adakarda/dengerobot/elektronik/cdtp_robot.pdf

1 | 2 | 3 | 4 | 5 | 6 | 7 | 8
1 | 2 | 3 | 4 | 5 | 6 | 7 | 8

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
Size: A3 | Rev: v1.3 | F Date: 2026-10-29
KiCad E.D.A. 10.0.6 | Id: 1/1

## Title: CDTP denge robotu - robot elektronigi

### File: cdtp_robot.kicad_sch

### Sheet: /

YTU EEF CDTP

### Uretici: tools/kicad_sema.py (elle duzenlemeyin; betigi degistirip yeniden uretin)

B- 1 | B1 2 | B2 3 | B+ 4 | P- | 5 U2 HX-3S-01

1
2
3

J6 GENISLEME: IR goz sol (bos) 1

2

# J9 GENISLEME: sarj girisi (bos) 1

2
3
4

J5

Enkoder sag NC1 1 | NC2 | 2

S1 NP2-BE102 NC

BT3

18650 hucre 3

1
2
3
4

J4

Enkoder sol 1
2

J1

5 V klemens | VCC 1 | GND 2

SCL 3
SDA 4
XDA 5
XCL 6
AD0 7
INT 8

A1 GY-521 C5

1000uF 25V +

1 | -
2 | J11
XT60 disi (pil) | R1

100k

BT1

18650 hucre 1

1
2
3
4
5
X2 WAGO-GND (yildiz) | 1

2
3
4

J13 GENISLEME: I2C (ekran, 2. sensor)

3V3 1
EN 2 | GPIO36_VP 3 | GPIO39_VN 4 | GPIO34 5 | GPIO35 6 | GPIO32 7 | GPIO33 8 | GPIO25 9 | GPIO26 10 | GPIO27 11 | GPIO14 12 | GPIO12 13 | GND 14 | GPIO13 15

SD2 16
SD3 17 | CMD 18
5V 19 | GND | 20 GPIO23 | 21 GPIO22 | 22
TX_GPIO1 | 23 RX_GPIO3 | 24 GPIO21 | 25 GND | 26 GPIO19 | 27 GPIO18 | 28 GPIO5 | 29 GPIO17 | 30 GPIO16 | 31 GPIO4 | 32 GPIO0 | 33 GPIO2 | 34 GPIO15 | 35
SD1 | 36
SD0 | 37 CLK | 38 U1

ESP32-WROOM-32D DevKitC

1
2
3

J7 GENISLEME: IR goz sag (bos) R5

10k

F1

5 A bicak BT2

# 18650 hucre 2 +

1 | -
2 | J12
XT60 erkek (robot) | 1
| 2
| 3
| 4
| 5

X1 WAGO-12V

JP1 USB'de cikar C1

100uF 16V

IN+ 1

IN- 2 | OUT+ | 3 OUT- | 4 U3
LM2596 5,0 V | 1

2

J10 Motor hatti klemens

C4

# 100nF R4

27k R7

33k 1
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
J3 BTS sol | R3

100k R2

27k C2

# 100nF R6

100k C3

100nF 1
2
3
4
5
J8 BTS sag | M1 1 | GND | 2 C1 | 3 C2 | 4
VCC | 5 M2 6 | M2
JGB37-520 sag M1 1 | GND | 2 C1 | 3 C2 | 4
VCC | 5 M2 6 | M1

# JGB37-520 sol RPWM 1

LPWM 2 | R_EN 3
L_EN 4 | R_IS 5

L_IS 6

VCC 7 | GND 8 | B+ | 9 B- | 10 M+ | 11 M- | 12

# A2 BTS7960 sol RPWM 1

LPWM 2 | R_EN 3
L_EN 4 | R_IS 5

L_IS 6

VCC 7 | GND 8 | B+ | 9 B- | 10 M+ | 11 M- | 12

# A3 BTS7960 sag

I2C_SCL

B1 | +12V
B1 | +3V3

I2C_SDA

B2 | B2

IR_L PACK+
IR_R

PACK-

CHG+

VBAT_ADC
ENC_L_A ENC_L_B
ENC_R_A ENC_R_B | MOT_L- +12V B-

ENC_R_B +12V B2 PACK+

MOT_L+

PACK+

+3V3 PACK-

GND

R_LPWM

BAT+

R_RPWM
MOTOR_EN
GND | +12V_MOT | GND +12V_MOT

IMU_INT +3V3 BAT+

I2C_SDA +12V +12V +12V +12V +12V | GND
L_LPWM +12V_MOT | L_RPWM

# R_LPWM +3V3 GND

R_RPWM

GND | MOTOR_EN MOTOR_EN

GND

L_LPWM +3V3

L_RPWM +5V_ESP

GND

IR_L +5V

VBAT_ADC

B1 | GND

GND
GND
GND
GND

GND

GND +5V
I2C_SCL ENC_R_A GND
GND +5V | +12V_MOT GND +12V +3V3 | MOTOR_SENSE | GND

ENC_L_A GND

I2C_SCL
I2C_SDA
IMU_INT +3V3 +12V

VBAT_ADC

CHG+ | VCHG_ADC
VCHG_ADC | GND

GND

VBAT_ADC | GND

GND +5V_ESP

GND

GND

GND

MOTOR_EN +3V3 GND

I2C_SDA | MOTOR_SENSE GND MOTOR_EN

VCHG_ADC +12V_MOT MOTOR_SENSE

IR_R | MOT_L+ MOT_L-

GND

# ENC_R_A ENC_R_B +3V3 GND

ENC_L_A ENC_L_B +3V3 MOT_R-

MOT_R+

+5V

VCHG_ADC

I2C_SCL GND

IMU_INT GND MOTOR_SENSE | +3V3 GND

L_RPWM
L_LPWM
MOTOR_EN +3V3 | +3V3 GND
ENC_L_B | +3V3 GND

B-

+12V_MOT GND MOT_R+

MOT_R-

R_RPWM
R_LPWM
MOTOR_EN MOTOR_EN Sarj eklentisi (sonra): pogo + -> SR5100 anot, katot -> BAT+ (sigortadan once), pogo + ayrica J9-2. R3/R4 GPIO34'u 0 V'ta tutar.

Guc: pil -> BMS -> XT60 -> F1 5 A -> WAGO-12V. Acil stop (NC) yalniz motor hattini keser; ESP32 acik kalir.

ANA KART: ESP32 VE BESLEME | MODULLER VE MOTORLAR

KAPSAM: yalniz dengede kalan, pilli robot. GENISLEME konnektorleri (J6, J7, J9, J13) bos birakildi; sarj, IR goz, ekran sonradan buraya takilir.

JP1: kod yuklerken (USB takiliyken) cikarin; LM2596 ile USB 5 V'u cakismasin.

# ANA KART: KONNEKTOR, OLCUM

CDTP denge robotu - robot elektronigi (tek sayfa). Ayni adli etiketler ayni hattir.

Bolucu: R1/R2 ve R3/R4 100k/27k (12,6 V -> 2,68 V); R6/R7 100k/33k (12,6 V -> 3,13 V).

PIL VE BMS | 12 V DAGITIM

BTS7960 VCC = 3,3 V (ESP32 seviyesi). R_EN ve L_EN iki kartta GPIO4'e; R5 10k ile acilista motorlar kapali.

Kablo numaralari (W1-W44) ve pin sirasi: docs/robot.html bolum 04, 06, 07.

MPU6050 AD0 -> GND (adres 0x68). GPIO36/39 yalniz giris (IR, PCNT 12,8 us suzgec).
