adakarda/dengerobot/cad/dxf/onizleme.png

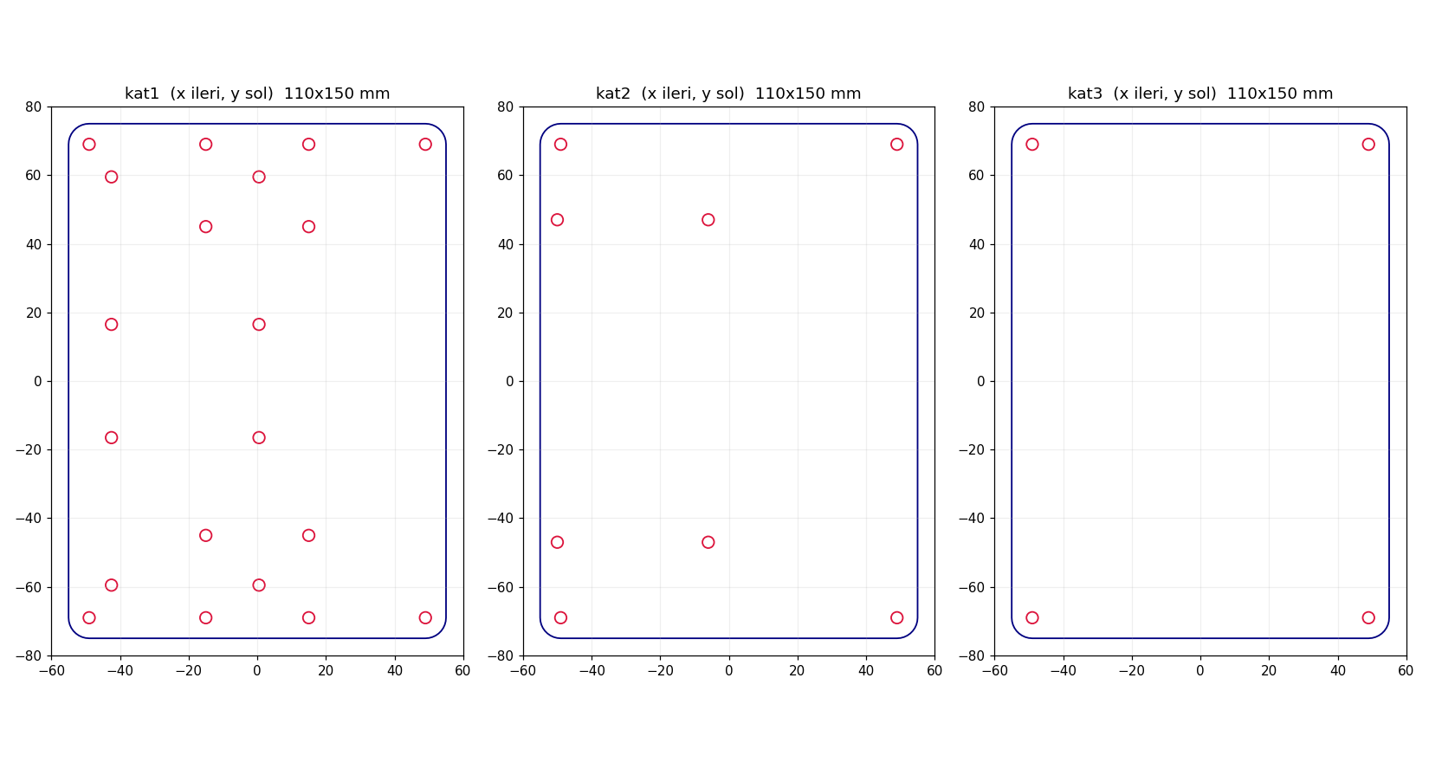
cad/dxf/onizleme.png
