adakarda/dengerobot/cad/dxf/yerlesim.png

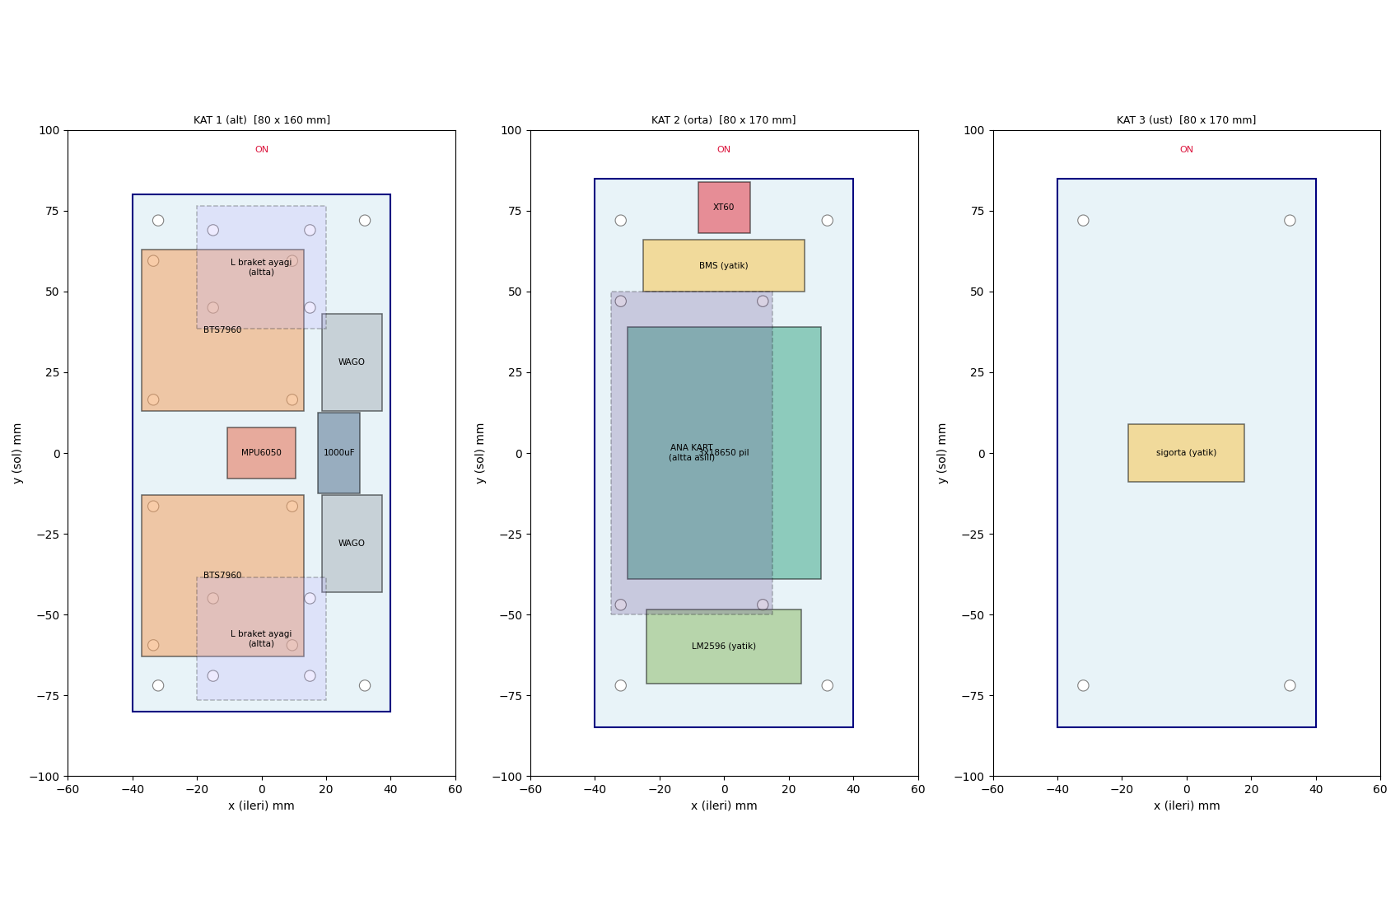
cad/dxf/yerlesim.png
