adakarda/dengerobot/docs/img/c1_ileri.png

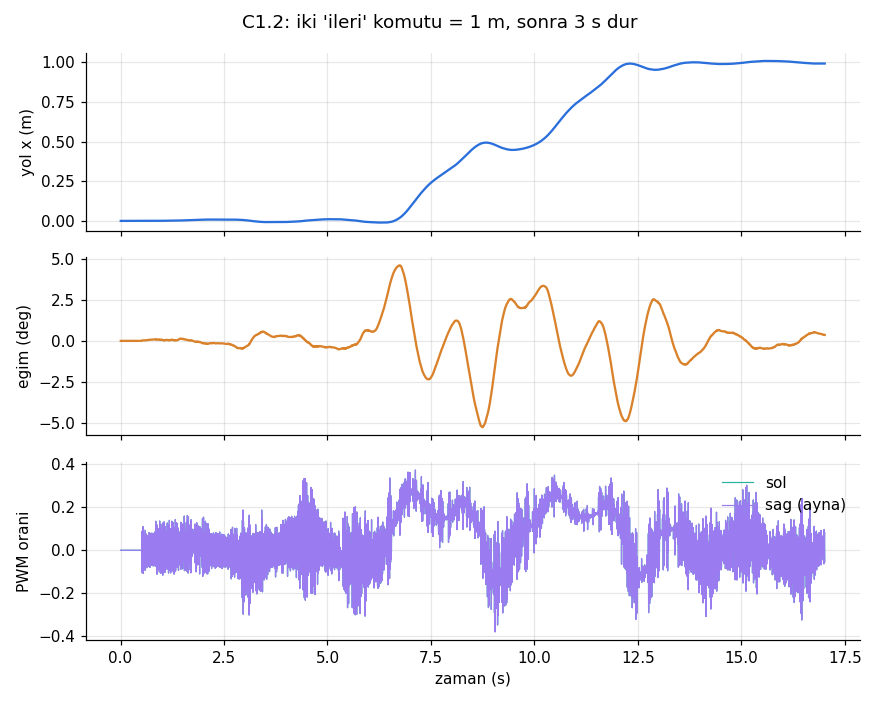
docs/img/c1_ileri.png
