adakarda/dengerobot/docs/img/c1_toparlanma.png

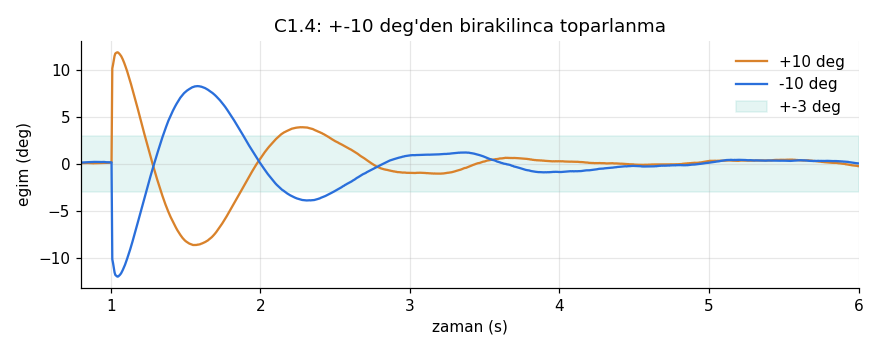
docs/img/c1_toparlanma.png
