adakarda/dengerobot/docs/img/c2_eldiven.png

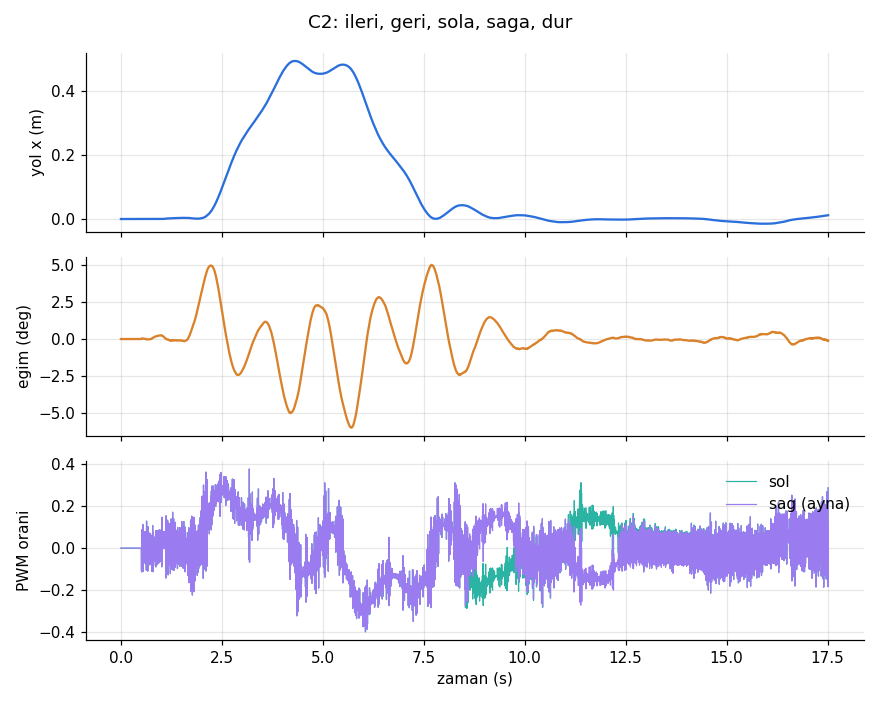
docs/img/c2_eldiven.png
