adakarda/dengerobot/docs/img/cad_parcalar.png

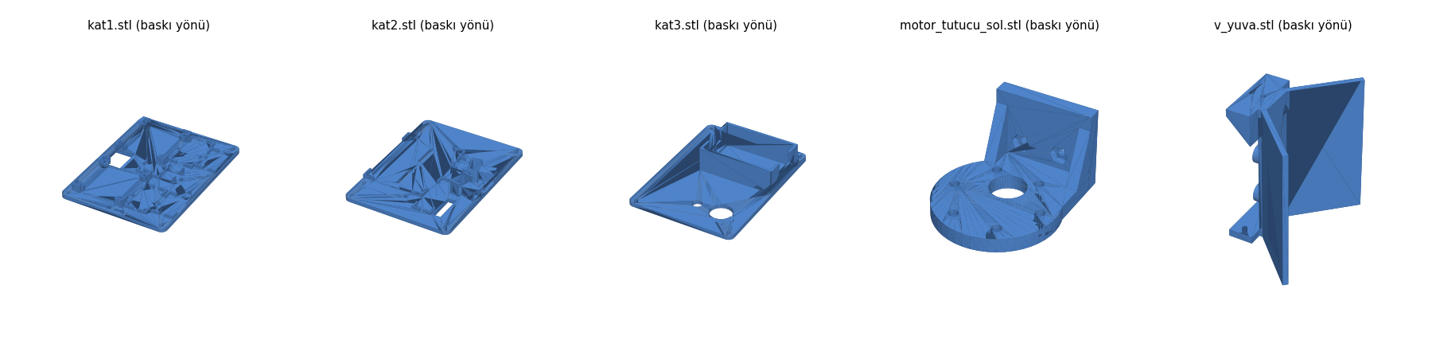
docs/img/cad_parcalar.png
