adakarda/dengerobot/docs/img/ikiz_karsilastirma.png

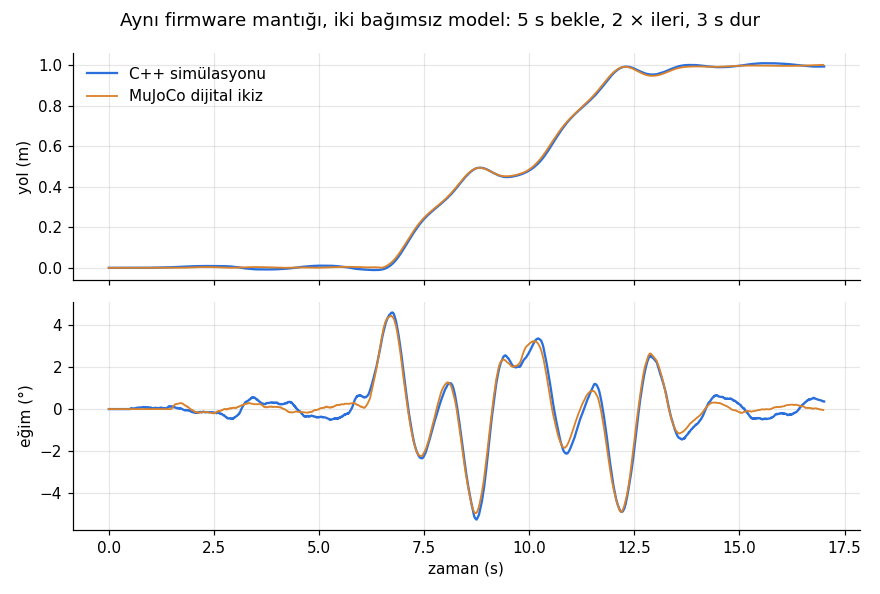
docs/img/ikiz_karsilastirma.png
