adakarda/dengerobot/docs/img/ikiz_yanasma.png

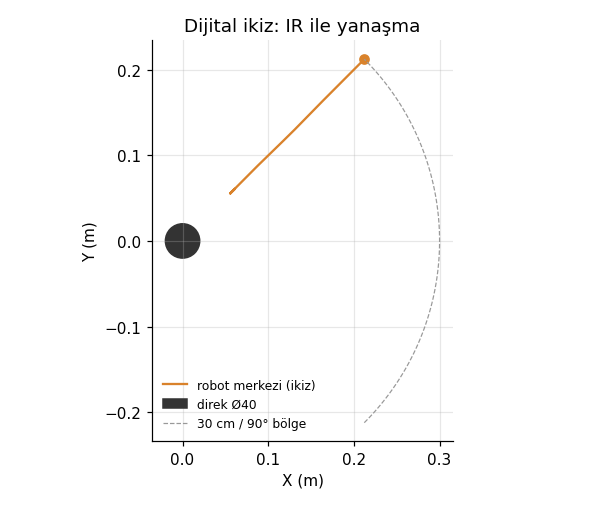
docs/img/ikiz_yanasma.png
