adakarda/dengerobot/docs/img/yanasma_yolu.png

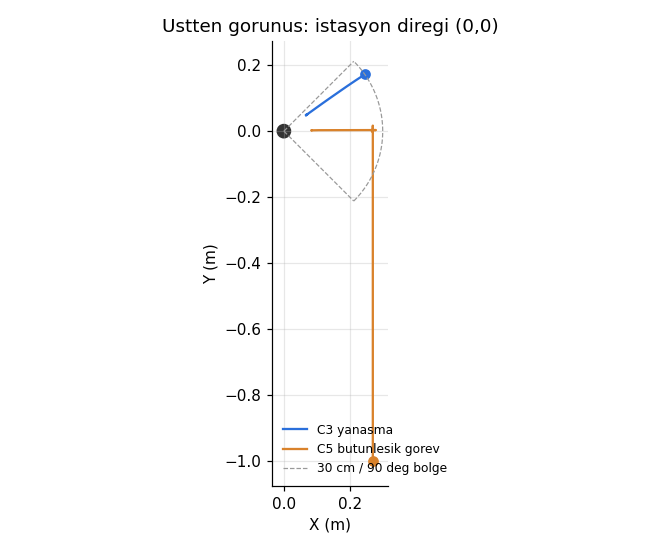
docs/img/yanasma_yolu.png
