adakarda/dengerobot/elektronik/pcb_v2/onizleme_alt.png

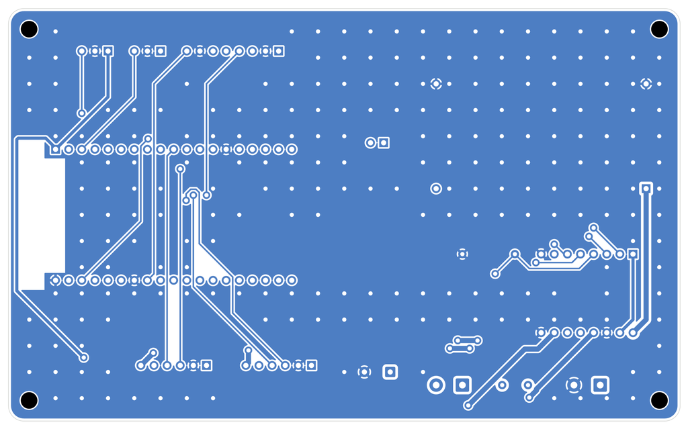
elektronik/pcb_v2/onizleme_alt.png
