adakarda/dengerobot/elektronik/pcb_v2/onizleme_ust.png

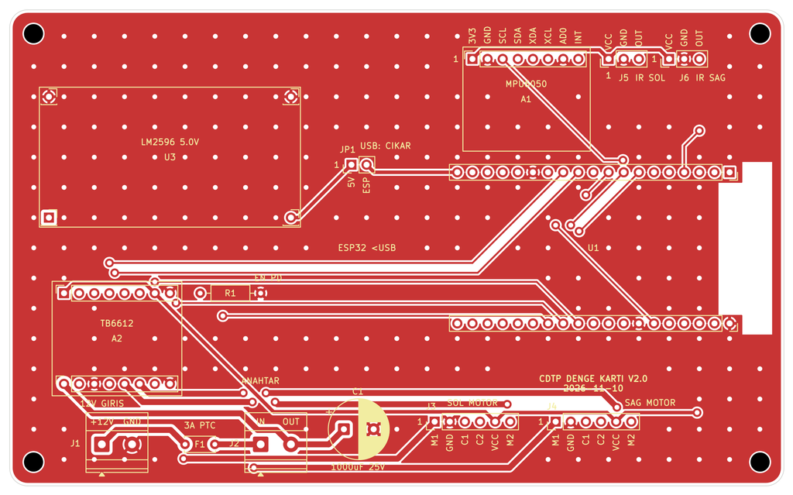
elektronik/pcb_v2/onizleme_ust.png
