adakarda/dengerobot/cad/dxf/pleksi_hepsi.dxf

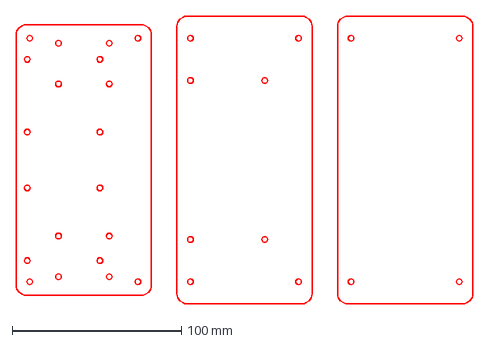
[picture p26: CAD file, 2026-11-11]
cad/dxf/pleksi_hepsi.dxf
270.0 x 170.0 mm
