adakarda/dengerobot/cad/stl/motor_tutucu_sag.stl

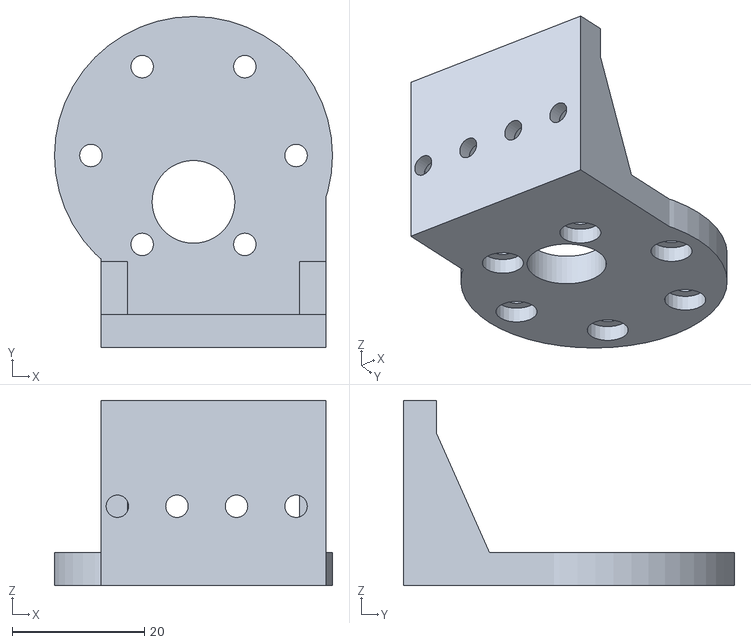
[picture p27: CAD file, 2026-11-11]
cad/stl/motor_tutucu_sag.stl
42.0 x 50.0 x 28.0
