adakarda/dengerobot/cad/stl/motor_braket_37mm.stl

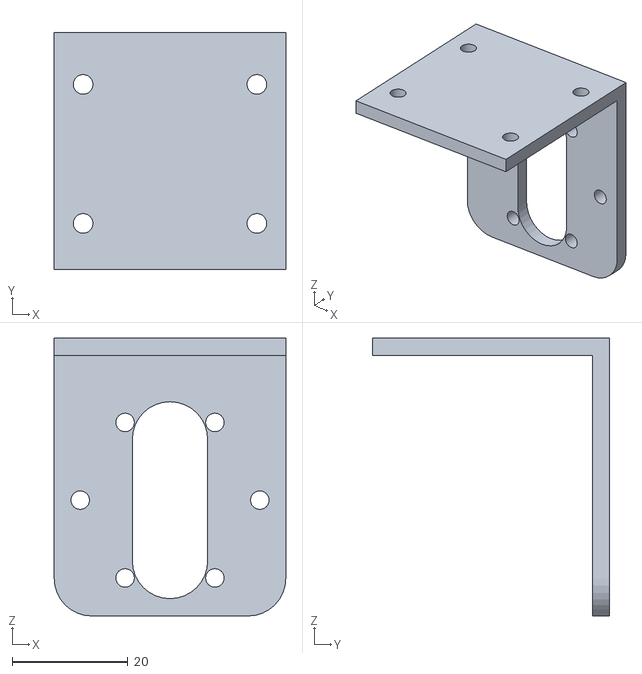
[picture p28: CAD file, 2026-11-11]
cad/stl/motor_braket_37mm.stl
40.0 x 41.0 x 48.0
