adakarda/dengerobot/cad/stl/kat1.stl

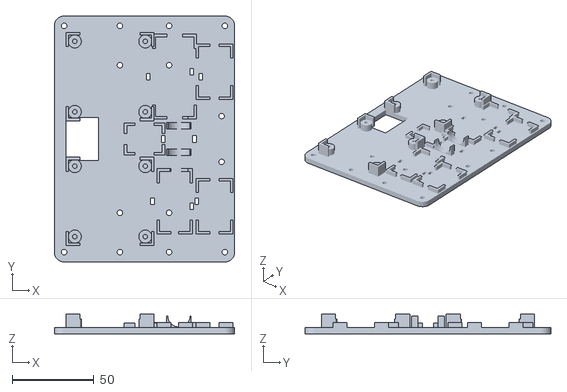
[picture p29: CAD file, 2026-11-11]
cad/stl/kat1.stl
110.0 x 150.0 x 12.0
