adakarda/dengerobot/cad/stl/teker_kapak_B.stl

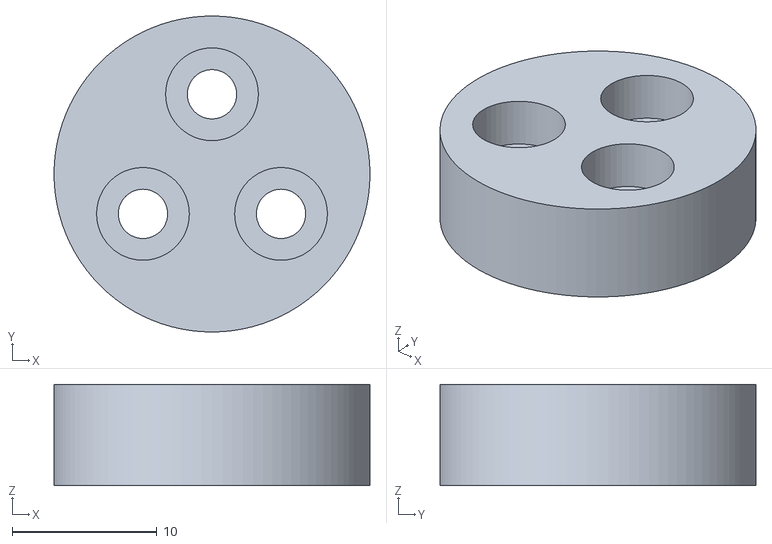
[picture p30: CAD file, 2026-11-05]
cad/stl/teker_kapak_B.stl
21.8 x 21.8 x 7.00
