adakarda/dengerobot/cad/stl/teker_olcu_testi.stl

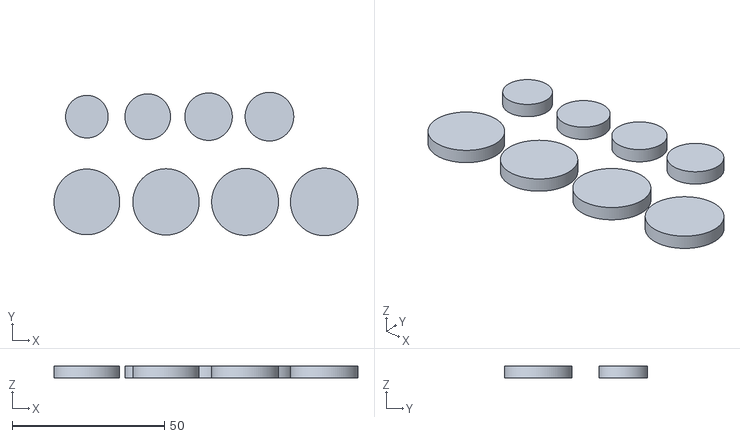
[picture p31: CAD file, 2026-11-05]
cad/stl/teker_olcu_testi.stl
99.9 x 47.1 x 4.00
