adakarda/dengerobot/cad/stl/teker_gobek_A.stl

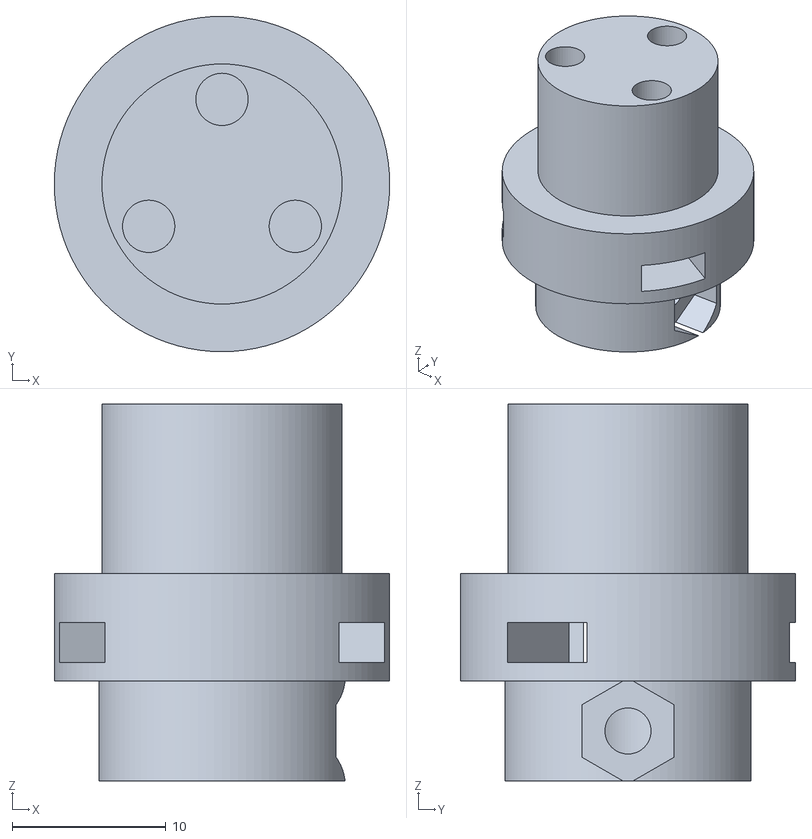
[picture p32: CAD file, 2026-11-05]
cad/stl/teker_gobek_A.stl
21.8 x 21.8 x 24.5
