adakarda/dengerobot/cad/stl/v_yuva.stl

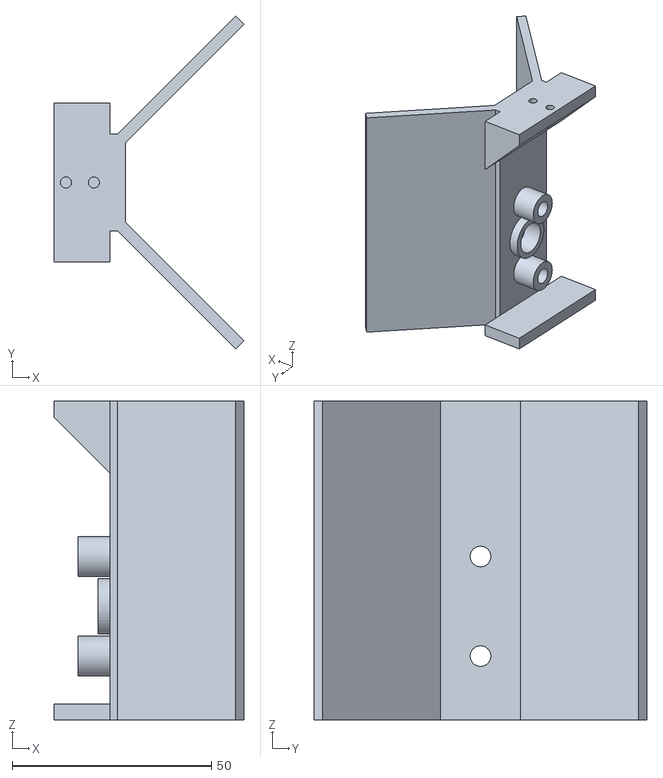
[picture p33: CAD file, 2026-11-05]
cad/stl/v_yuva.stl
47.7 x 83.6 x 80.0
