adakarda/dengerobot/cad/stl/kat2.stl

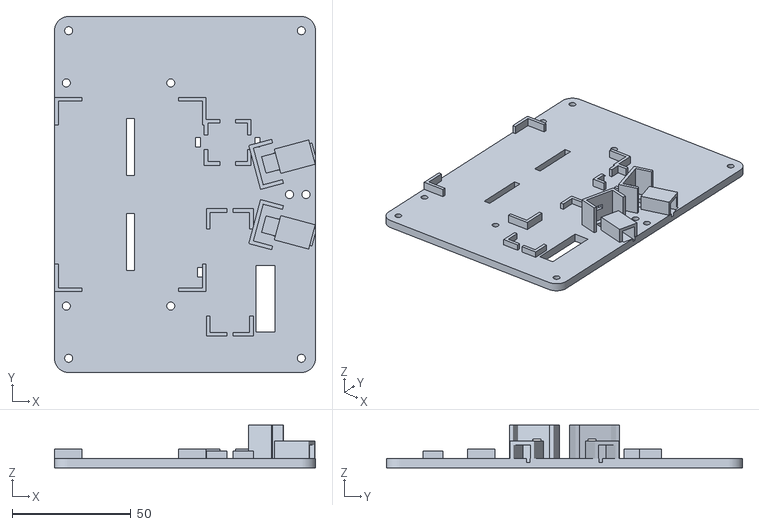
[picture p34: CAD file, 2026-11-05]
cad/stl/kat2.stl
110.0 x 150.0 x 18.0
