adakarda/dengerobot/cad/stl/kat3.stl

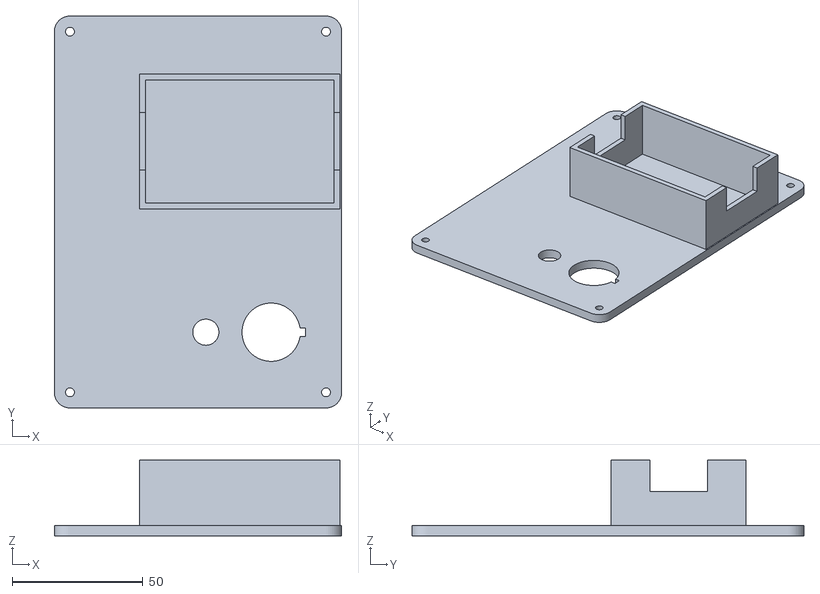
[picture p35: CAD file, 2026-10-29]
cad/stl/kat3.stl
110.0 x 150.0 x 29.0
