adakarda/dengerobot/(list of files, cad)

Other CAD files:
cad/stl/motor_tutucu_sol.stl
cad/dxf/kat1.dxf
cad/dxf/kat2.dxf
cad/dxf/kat3.dxf
