adakarda/dengerobot/docs/img/cad_montaj.png

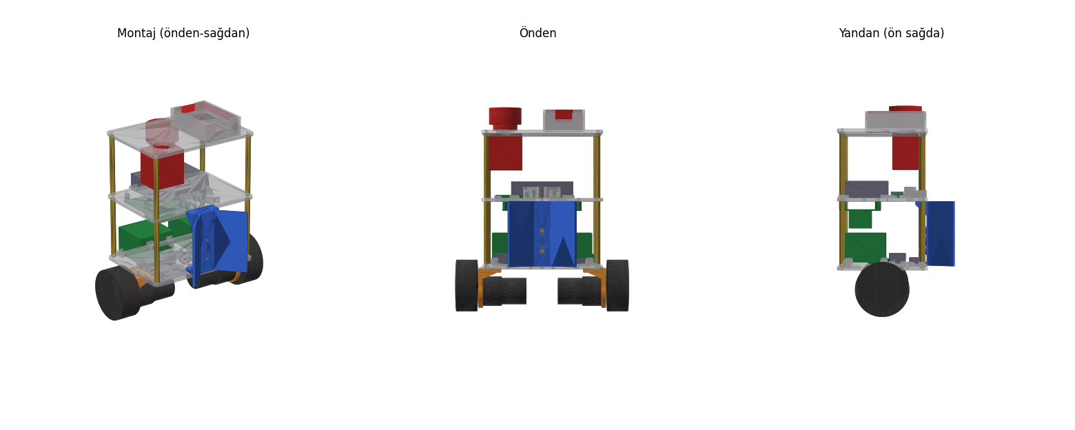
docs/img/cad_montaj.png
