adakarda/dengerobot/sim/results/filtre_izgara.tsv

q_theta | r_acc | q_bias | rms_ort_deg | bias_ort_dps
1e-008 | 0.0004 | 1e-013 | 0.2566 | 0.0015
1e-008 | 0.0004 | 1e-011 | 0.2567 | 0.0015
1e-008 | 0.0004 | 1e-009 | 0.2681 | 0.0025
1e-008 | 0.0004 | 1e-007 | 0.4712 | 0.0191
1e-008 | 0.0016 | 1e-013 | 0.2533 | 0.0014
1e-008 | 0.0016 | 1e-011 | 0.2533 | 0.0014
1e-008 | 0.0016 | 1e-009 | 0.2562 | 0.0015
1e-008 | 0.0016 | 1e-007 | 0.3762 | 0.0119
1e-008 | 0.0064 | 1e-013 | 0.2515 | 0.0014
1e-008 | 0.0064 | 1e-011 | 0.2515 | 0.0014
1e-008 | 0.0064 | 1e-009 | 0.2522 | 0.0014
1e-008 | 0.0064 | 1e-007 | 0.3065 | 0.0102
1e-008 | 0.025 | 1e-013 | 0.2540 | 0.0014
1e-008 | 0.025 | 1e-011 | 0.2540 | 0.0014
1e-008 | 0.025 | 1e-009 | 0.2542 | 0.0014
1e-008 | 0.025 | 1e-007 | 0.2722 | 0.0034
1e-008 | 0.1 | 1e-013 | 0.2757 | 0.0017
1e-008 | 0.1 | 1e-011 | 0.2757 | 0.0017
1e-008 | 0.1 | 1e-009 | 0.2758 | 0.0017
1e-008 | 0.1 | 1e-007 | 0.2799 | 0.0016
1e-008 | 0.4 | 1e-013 | 0.3532 | 0.0034
1e-008 | 0.4 | 1e-011 | 0.3532 | 0.0034
1e-008 | 0.4 | 1e-009 | 0.3532 | 0.0034
1e-008 | 0.4 | 1e-007 | 0.3528 | 0.0023
1e-008 | 1.6 | 1e-013 | 0.5671 | 0.0118
1e-008 | 1.6 | 1e-011 | 0.5671 | 0.0118
1e-008 | 1.6 | 1e-009 | 0.5670 | 0.0118
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
