adakarda/dengerobot/sim/results/gozleyici_izgara.tsv

sa | salpha | rx | rth_deg | v_rms | th_rms_deg | om_rms_dps
0.5 | 5 | 0.0005 | 0.1 | 0.00000 | 0.0060 | 0.2511
0.5 | 5 | 0.0005 | 0.1 | 1.00000 | 0.0058 | 0.2422
0.5 | 5 | 0.0005 | 0.1 | 4.00000 | 0.0059 | 0.2416
0.5 | 5 | 0.0005 | 0.1 | 16.00000 | 0.0063 | 0.2415
0.5 | 5 | 0.0005 | 0.3 | 0.00000 | 0.0060 | 0.2346
0.5 | 5 | 0.0005 | 0.3 | 1.00000 | 0.0058 | 0.2443
0.5 | 5 | 0.0005 | 0.3 | 4.00000 | 0.0057 | 0.2428
0.5 | 5 | 0.0005 | 0.3 | 16.00000 | 0.0058 | 0.2427
0.5 | 5 | 0.002 | 0.1 | 0.00000 | 0.0082 | 0.2458
0.5 | 5 | 0.002 | 0.1 | 1.00000 | 0.0074 | 0.2422
0.5 | 5 | 0.002 | 0.1 | 4.00000 | 0.0074 | 0.2416
0.5 | 5 | 0.002 | 0.1 | 16.00000 | 0.0080 | 0.2414
0.5 | 5 | 0.002 | 0.3 | 0.00000 | 0.0073 | 0.2330
0.5 | 5 | 0.002 | 0.3 | 1.00000 | 0.0073 | 0.2443
0.5 | 5 | 0.002 | 0.3 | 4.00000 | 0.0065 | 0.2428
0.5 | 5 | 0.002 | 0.3 | 16.00000 | 0.0062 | 0.2426
0.5 | 5 | 0.008 | 0.1 | 0.00000 | 0.0145 | 0.2325
0.5 | 5 | 0.008 | 0.1 | 1.00000 | 0.0108 | 0.2421
0.5 | 5 | 0.008 | 0.1 | 4.00000 | 0.0112 | 0.2416
0.5 | 5 | 0.008 | 0.1 | 16.00000 | 0.0131 | 0.2413
0.5 | 5 | 0.008 | 0.3 | 0.00000 | 0.0104 | 0.2192
0.5 | 5 | 0.008 | 0.3 | 1.00000 | 0.0106 | 0.2442
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
