adakarda/dengerobot/sim/results/gozleyici_karsilastirma.tsv

kestirim | v_ort_mms | v_kotu_mms | th_ort_deg | th_kotu_deg | om_ort_dps | om_kotu_dps
dogrudan (enkoder farki) | 4.139 | 4.266 | 0.2383 | 0.2573 | 2.4982 | 2.6957
gozleyici, gains.h | 4.725 | 5.171 | 0.2385 | 0.2576 | 2.4982 | 2.6957
gozleyici, izgara en iyisi | 4.725 | 5.171 | 0.2385 | 0.2576 | 2.4982 | 2.6957
