adakarda/dengerobot/sim_step/results/17HS3401S_c1_back.csv

t_s | x_m | v_mps | theta_deg | psi_deg | T_L_Ncm | T_R_Ncm | T_pullout_Ncm | wheel_rate_rad_s | x_deadreckoned_m | slips_total | mode
0.0050 | 0.00000 | 0.0000 | 0.000 | 0.000 | 0.00 | 0.00 | 0.00 | 0.000 | -0.00001 | 0 | 0
0.0100 | 0.00000 | 0.0000 | 0.000 | 0.000 | 0.00 | 0.00 | 0.00 | 0.000 | -0.00001 | 0 | 0
0.0150 | 0.00000 | 0.0000 | 0.000 | 0.000 | 0.00 | 0.00 | 0.00 | 0.000 | -0.00001 | 0 | 0
0.0200 | 0.00000 | 0.0000 | 0.000 | 0.000 | 0.00 | 0.00 | 0.00 | 0.000 | -0.00001 | 0 | 0
0.0250 | 0.00000 | 0.0000 | 0.000 | 0.000 | 0.00 | 0.00 | 0.00 | 0.000 | -0.00001 | 0 | 0
0.0300 | 0.00000 | 0.0000 | 0.000 | 0.000 | 0.00 | 0.00 | 0.00 | 0.000 | -0.00001 | 0 | 0
0.0350 | 0.00000 | 0.0000 | 0.000 | 0.000 | 0.00 | 0.00 | 0.00 | 0.000 | -0.00001 | 0 | 0
0.0400 | 0.00000 | 0.0000 | 0.000 | 0.000 | 0.00 | 0.00 | 0.00 | 0.000 | -0.00001 | 0 | 0
0.0450 | 0.00000 | 0.0000 | 0.000 | 0.000 | 0.00 | 0.00 | 0.00 | 0.000 | -0.00001 | 0 | 0
0.0500 | 0.00000 | 0.0000 | 0.000 | 0.000 | 0.00 | 0.00 | 0.00 | 0.000 | -0.00001 | 0 | 0
0.0550 | 0.00000 | 0.0000 | 0.000 | 0.000 | 0.00 | 0.00 | 0.00 | 0.000 | -0.00001 | 0 | 0
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
