adakarda/dengerobot/sim_step/results/recovery_limit.png

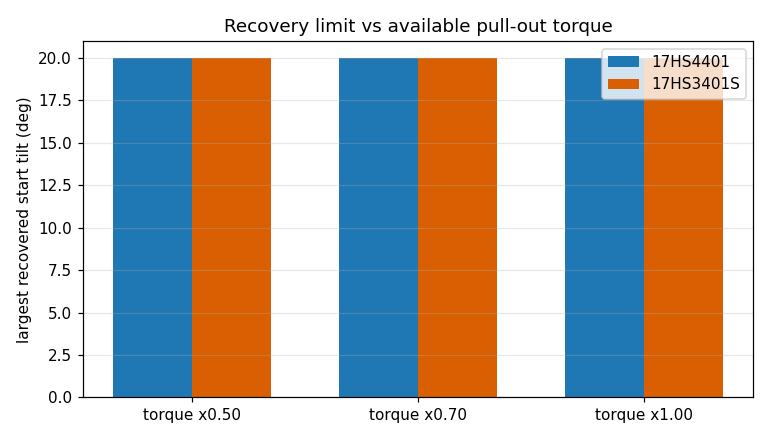
sim_step/results/recovery_limit.png
