adakarda/dengerobot/sim_step/results/recovery_plus10.png

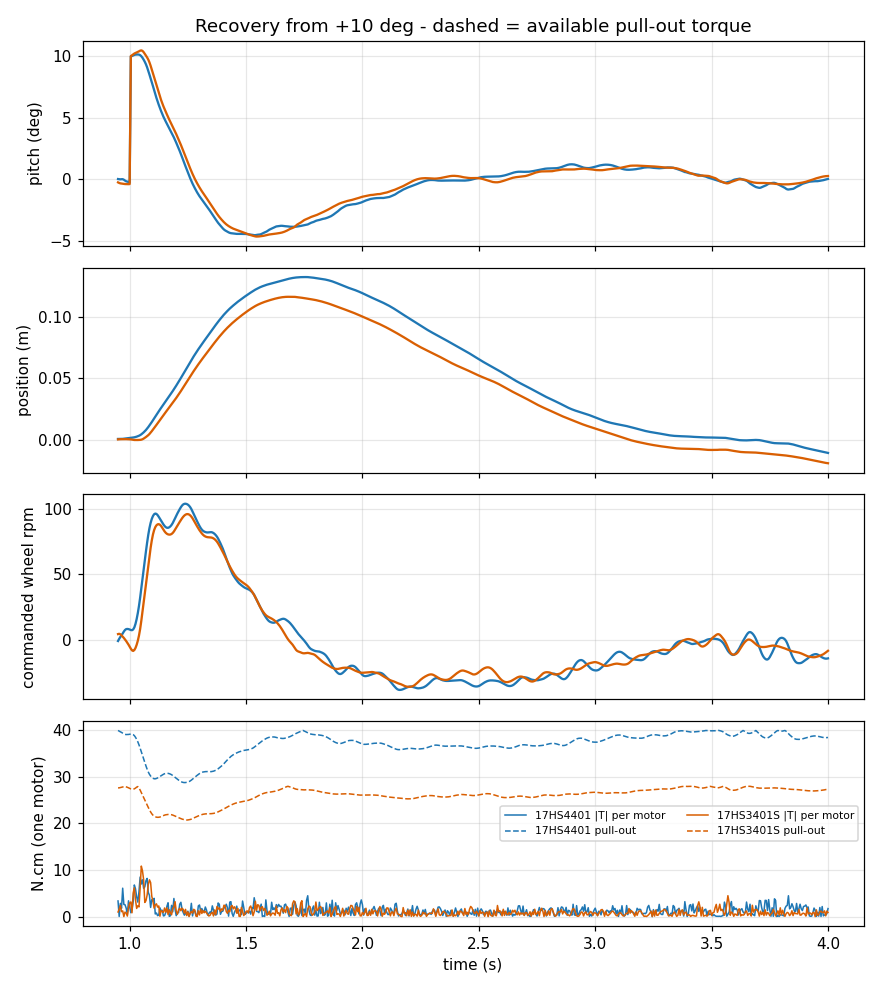
sim_step/results/recovery_plus10.png
