adakarda/dengerobot/sim_step/results/run_1m_forward.png

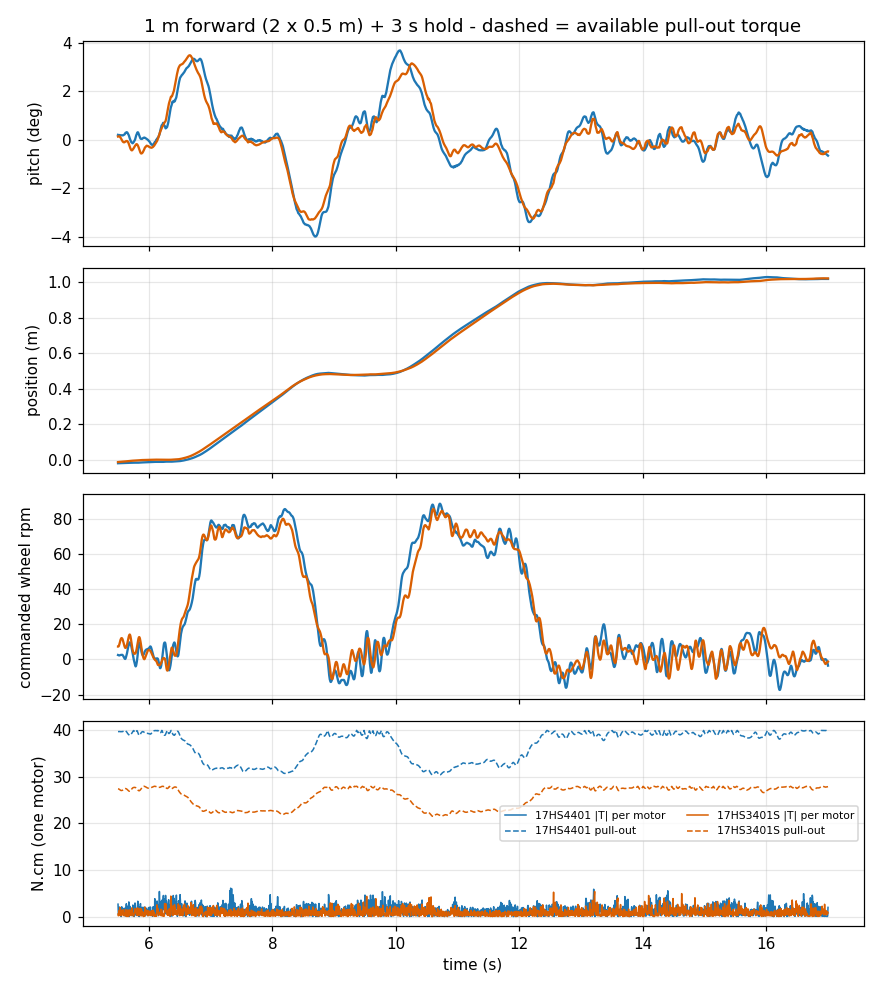
sim_step/results/run_1m_forward.png
