adakarda/dengerobot/elektronik/pcb_v2/cdtp_ana_kart_v2.kicad_pcb

## KiCad design elektronik/pcb_v2/cdtp_ana_kart_v2.kicad_pcb (2026-11-11)

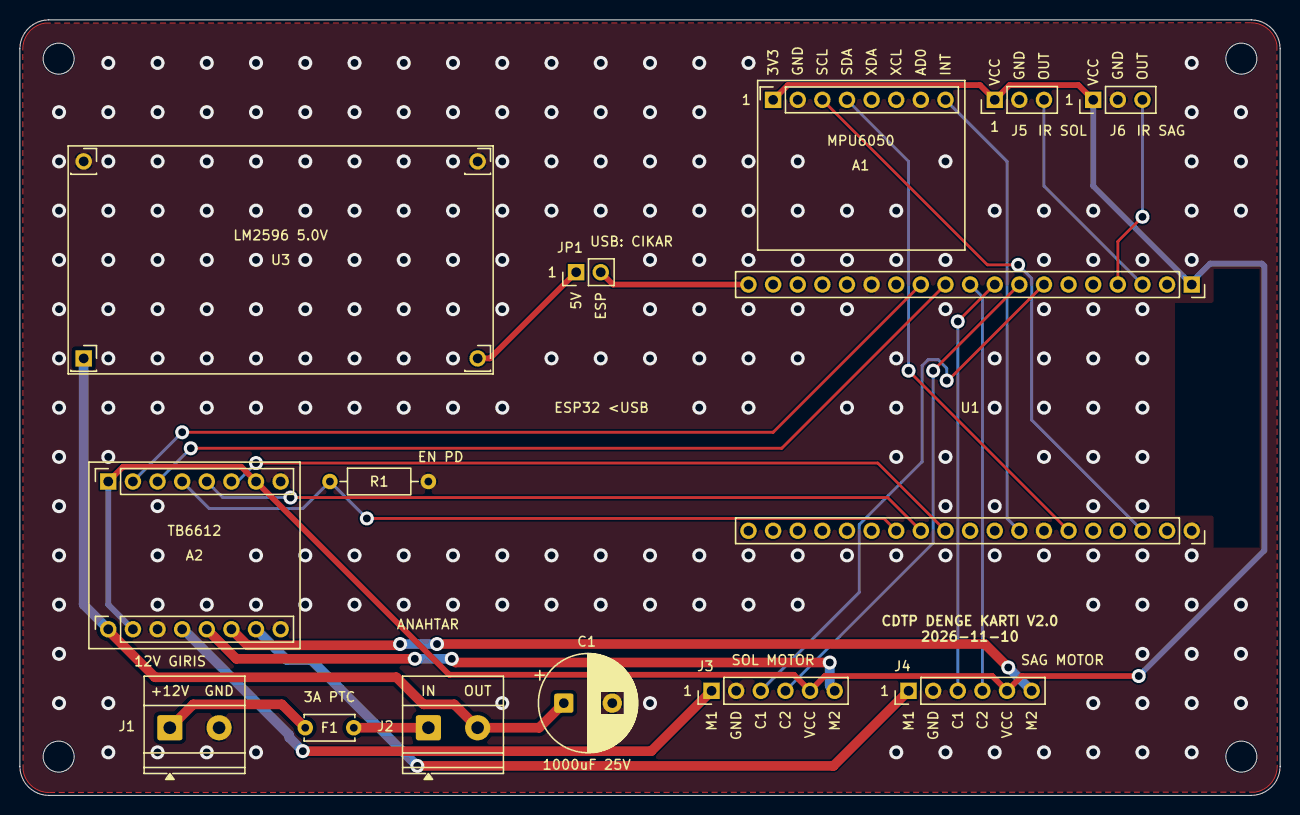
[picture p40: board cdtp_ana_kart_v2.kicad_pcb from above]

Board: 2 copper layers, 130.0 x 80.0 mm, 18 parts (0 on the bottom side), 25 nets.

Parts:
A1: GY-521 MPU6050 (1x8 soket); PinSocket_1x08_P2.54mm_Vertical
A2: TB6612FNG modul (2x8 soket); TB6612_2x8_PinSocket_P2.54mm
C1: 1000uF 25V; CP_Radial_D10.0mm_P5.00mm
F1: PTC sigorta 3 A; C_Disc_D5.0mm_W2.5mm_P5.00mm
H1, H2, H3, H4: M3; MountingHole_3.2mm_M3
J1: 12V ADAPTOR GIRIS klemens; TerminalBlock_Phoenix_MKDS-1,5-2-5.08_1x02_P5.08mm_Horizont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
J2: ANAHTAR klemens; TerminalBlock_Phoenix_MKDS-1,5-2-5.08_1x02_P5.08mm_Horizont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
J3: SOL MOTOR 6 pin; PinHeader_1x06_P2.54mm_Vertical
J4: SAG MOTOR 6 pin; PinHeader_1x06_P2.54mm_Vertical
J5: IR SOL; PinHeader_1x03_P2.54mm_Vertical
J6: IR SAG; PinHeader_1x03_P2.54mm_Vertical
JP1: USB'de cikar; PinHeader_1x02_P2.54mm_Vertical
R1: 10k; R_Axial_DIN0207_L6.3mm_D2.5mm_P10.16mm_Horizontal
U1: ESP32-WROOM-32D DevKitC 38 pin; ESP32_DevKitC_2x19_PinSocket_P2.54mm
U3: LM2596 mini 5,0 V (4 ped); LM2596_mini_4pad

Connections:
/+3V3: A1.1, A2.1, A2.7, A2.10, J3.5, J4.5, J5.1, J6.1, U1.1
/+5V: JP1.1, U3.3
/+5V_ESP: JP1.2, U1.19
/+12V: A2.9, C1.1, J2.2, U3.1
/ADP+: F1.1, J1.1
/ENC_L_A: J3.3, U1.7
/ENC_L_B: J3.4, U1.8
/ENC_R_A: J4.3, U1.9
/ENC_R_B: J4.4, U1.10
/FUSED: F1.2, J2.1
/GND: A1.2, A1.7, A2.8, A2.11, A2.16, C1.2, J1.2, J3.2, J4.2, J5.2, J6.2, R1.2, U1.14, U1.20, U1.26, U3.2, U3.4
/I2C_SCL: A1.3, U1.22
/I2C_SDA: A1.4, U1.25
/IMU_INT: A1.8, U1.27
/IR_L: J5.3, U1.3
/IR_R: J6.3, U1.4
/L_LPWM: A2.2, U1.12
/L_RPWM: A2.3, U1.11
/MOTOR_EN: A2.4, R1.1, U1.32
/MOT_L+: A2.12, J3.1
/MOT_L-: A2.13, J3.6
/MOT_R+: A2.15, J4.1
/MOT_R-: A2.14, J4.6
/R_LPWM: A2.6, U1.30
/R_RPWM: A2.5, U1.31
