adakarda/dengerobot/elektronik/pcb/cdtp_ana_kart.kicad_pcb

## KiCad design elektronik/pcb/cdtp_ana_kart.kicad_pcb (2026-11-05, an earlier design)

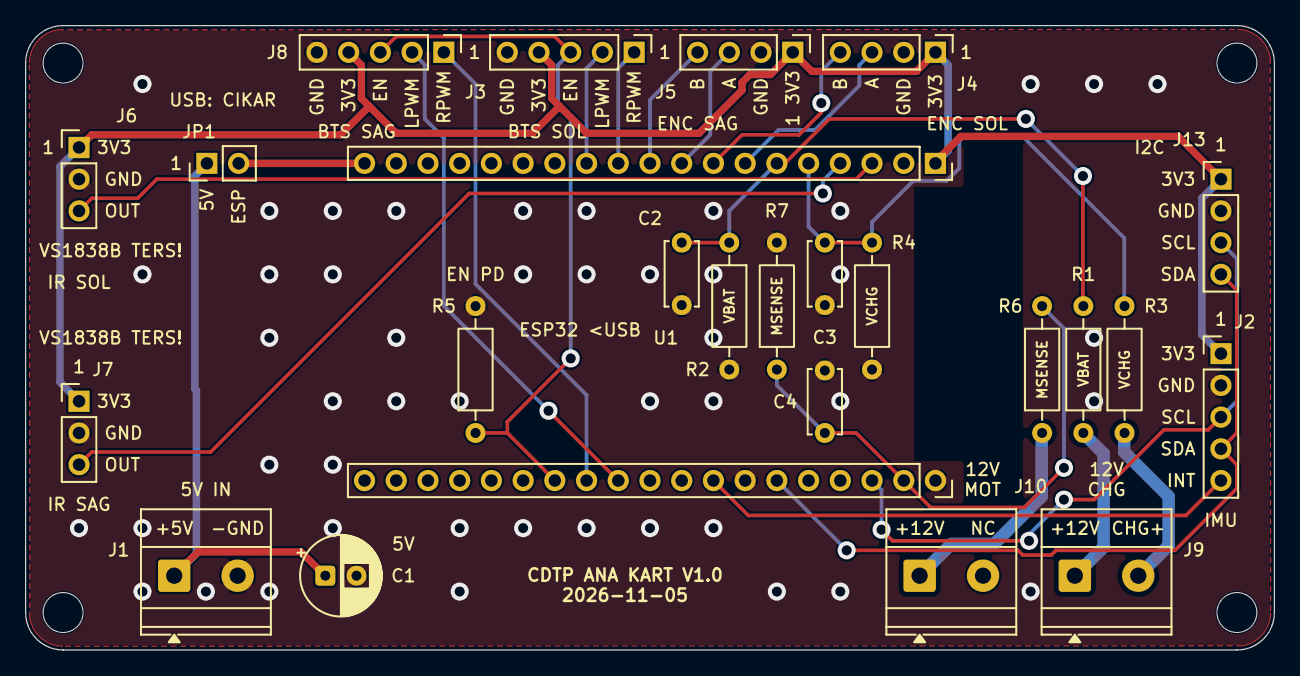
[picture p41: board cdtp_ana_kart.kicad_pcb from above]

Board: 2 copper layers, 100.0 x 50.0 mm, 28 parts (0 on the bottom side), 24 nets.

Parts:
C1: 100uF 16V; CP_Radial_D6.3mm_P2.50mm
C2, C3, C4: 100nF; C_Disc_D5.0mm_W2.5mm_P5.00mm
H1, H2, H3, H4: M3; MountingHole_3.2mm_M3
J1: 5 V klemens; TerminalBlock_Phoenix_MKDS-1,5-2-5.08_1x02_P5.08mm_Horizont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
J2: IMU; PinHeader_1x05_P2.54mm_Vertical
J3: BTS sol; PinHeader_1x05_P2.54mm_Vertical
J4: Enkoder sol; PinHeader_1x04_P2.54mm_Vertical
J5: Enkoder sag; PinHeader_1x04_P2.54mm_Vertical
J6: GENISLEME: IR goz sol (bos); PinHeader_1x03_P2.54mm_Vertical
J7: GENISLEME: IR goz sag (bos); PinHeader_1x03_P2.54mm_Vertical
J8: BTS sag; PinHeader_1x05_P2.54mm_Vertical
J9: GENISLEME: sarj girisi (bos); TerminalBlock_Phoenix_MKDS-1,5-2-5.08_1x02_P5.08mm_Horizont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
J10: Motor hatti klemens; TerminalBlock_Phoenix_MKDS-1,5-2-5.08_1x02_P5.08mm_Horizont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
J13: GENISLEME: I2C (ekran, 2. sensor); PinHeader_1x04_P2.54mm_Vertical
JP1: USB'de cikar; PinHeader_1x02_P2.54mm_Vertical
R1, R3, R6: 100k; R_Axial_DIN0207_L6.3mm_D2.5mm_P10.16mm_Horizontal
R2, R4: 27k; R_Axial_DIN0207_L6.3mm_D2.5mm_P10.16mm_Horizontal
R5: 10k; R_Axial_DIN0207_L6.3mm_D2.5mm_P10.16mm_Horizontal
R7: 33k; R_Axial_DIN0207_L6.3mm_D2.5mm_P10.16mm_Horizontal
U1: ESP32-WROOM-32D DevKitC; ESP32_DevKitC_2x19_PinSocket_P2.54mm

Connections:
/+3V3: J2.1, J3.4, J4.1, J5.1, J6.1, J7.1, J8.4, J13.1, U1.1
/+5V: C1.1, J1.1, JP1.1
/+5V_ESP: JP1.2, U1.19
/+12V: J9.1, R1.1
/+12V_MOT: J10.1, R6.1
/CHG+: J9.2, R3.1
/ENC_L_A: J4.3, U1.7
/ENC_L_B: J4.4, U1.8
/ENC_R_A: J5.3, U1.9
/ENC_R_B: J5.4, U1.10
/GND: C1.2, C2.2, C3.2, C4.2, J1.2, J2.2, J3.5, J4.2, J5.2, J6.2, J7.2, J8.5, J13.2, R2.2, R4.2, R5.2, R7.2, U1.14, U1.20, U1.26
/I2C_SCL: J2.3, J13.3, U1.22
/I2C_SDA: J2.4, J13.4, U1.25
/IMU_INT: J2.5, U1.27
/IR_L: J6.3, U1.3
/IR_R: J7.3, U1.4
/L_LPWM: J3.2, U1.12
/L_RPWM: J3.1, U1.11
/MOTOR_EN: J3.3, J8.3, R5.1, U1.32
/MOTOR_SENSE: C4.1, R6.2, R7.1, U1.21
/R_LPWM: J8.2, U1.30
/R_RPWM: J8.1, U1.31
/VBAT_ADC: C2.1, R1.2, R2.1, U1.6
/VCHG_ADC: C3.1, R3.2, R4.1, U1.5
