adakarda/dengerobot/sim/observer_grid.h

// OTOMATIK URETILDI: python tools/lqr_design.py --gozleyici-izgara
#pragma once
constexpr int OBS_GRID_N = 288;
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
  {{0.3969918f, -0.03101717f, -2.352052e-05f}, {20.80676f, -4.252544f, -0.005071674f}, {-0.2125883f, 0.1819718f, 0.0001420526f}, {-0.0001612071f, 0.0001420526f, 0.9999866f}, {262.4821f, -127.5993f, -0.2311299f}},
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
};
