adakarda/dengerobot/(commit log)

2026-10-28 Denge robotu: firmware, LQR tasarimi ve simulasyon
    - common/cdtp_core: robot ve eldivenin ortak cekirdegi (mod makinesi, LQR, hareket adimlari, IR yanasma, jest)
    - firmware/robot: ESP32-WROOM-32D (MPU6050, PCNT, BTS7960, ESP-NOW, BLE)
    - firmware/glove: ESP32-C3 eldiven
    - tools/lqr_design.py: model ve kazanc uretimi
    - sim: 20 kabul testi, hepsi geciyor
    - docs: plan sayfasi, BLE protokolu, grafikler
    [summary.tsv]
2026-10-28 Robot yapim dosyasi: sematikler, kablo listesi, sasi, tum kod
    - docs/robot.html: yalniz robot icin parca listesi, guc/sinyal semasi, ana kart, kablo listesi, sasi olculeri, V-yuva sarj temasi, firmware ve gomulu kaynak kodlar
    - tools/mass_budget.py: sasi kutle butcesi; model ve LQR kazanclari buna gore guncellendi (KM 72 mm, iz 190 mm)
    - Belirsizlik testi tahmin edilen KM etrafinda; 20/20 gecti, firmware yeniden derlendi
    [summary.tsv]
2026-10-29 Dogrulama: MuJoCo dijital ikizi, GitHub karsilastirmasi, tutarlilik denetimi, PDF kitap
    Dijital ikizde bulunan ve duzeltilen hatalar:
    - Jiroskop isareti: MPU6050 X ileri/Z yukari montajda one dusus gyro Y'de pozitif (AxisMap.pitchSign = +1)
    - Enkoder bagil aci olcer: x = r*phi_bagil + r*theta
    - Durduktan sonra kayma: dururken denge acisi ogrenme (TRIM_RATE, +-3 derece)
    - Sarjda geri yuvarlanma: V-yuvada miknatis, direkte celik serit
    - Ayrildiktan sonra hemen yeniden yanasma: UNDOCK_HOLD_S = 10 s
    Ekler:
    - twin/: MuJoCo modeli + RobotLogic koprusu, 11/11 test
    - tools/check_consistency.py: belge <-> kod, 41/41
    - tools/ref/github_karsilastirma.tsv: 6 acik kaynak denge robotu ile karsilastirma
    -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
    [github_karsilastirma.tsv, summary.tsv]
2026-10-29 3B baski parcalari ve KiCad semasi
    - cad/: parametrik 3B model (olcu.py), 6 STL (3 kat, V-yuva, 2 motor tutucu),
    38 parcalik montaj denetimi (carpisma, zemin, direk, pim/goz yuksekligi, KM)
    - elektronik/: KiCad 10 semasi (tools/kicad_sema.py), ERC 0/0, netlist pins.h
    ve kablo listesiyle karsilastirilir
    - Yerlesim degisti: pil kat 2 ustu, ana kart kat 2 alti, kutu ve acil stop
    one kaydirildi (KM x=0). Kutle butcesi, LQR kazanclari, ikiz guncellendi.
    - Miknatis yeri duzeltildi (pimlerin ortasi, celik serit hizasi)
    - Sim 20/20, ikiz 11/11, tutarlilik 50/50, firmware derleniyor
    [cdtp_robot.kicad_sch, github_karsilastirma.tsv, kat1.stl, kat2.stl, kat3.stl, motor_tutucu_sag.stl, motor_tutucu_sol.stl, summary.tsv]
2026-11-03 CAD: LM2596 48x23, sanziman boyu 22 mm; parca listesi sayfasi (link, alternatif, stok)
    [kat1.stl]
2026-11-03 Kapsam: yalniz dengede kalan robot; sema ve parca listesi sadelestirildi, genisleme konnektorleri
    [cdtp_robot.kicad_sch]
2026-11-05 70 mm Pololu 3272 tekerlek: yaricap 35 mm, kazanclar, CAD, ikiz; PCB duzeltmeleri; step simulasyonu (sim_step)
    [17HS3401S_c1_back.csv, 17HS3401S_c1_forward.csv, 17HS3401S_c1_recovery_minus.csv, 17HS3401S_c1_recovery_plus.csv, 17HS3401S_c1_static.csv, 17HS3401S_c2_glove.csv, 17HS4401_c1_back.csv, 17HS4401_c1_forward.csv]
2026-11-05 Tekerlek 3B baski surucu gobek (Pololu 3272, 6 mm D mil) + olcu testi
    [teker_gobek_A.stl, teker_kapak_B.stl, teker_olcu_testi.stl]
2026-11-09 Egim icin Kalman filtresi (aci + jiro bias) ve tumleyen filtreyle karsilastirma
    TiltKalman: [theta, b] durumlu 2x2 Kalman, ayni arayuz; -DCDTP_TILT_KALMAN=1 ile
    secilir, varsayilan tumleyen filtre (firmware degismedi). sim/filtre_karsilastir.cpp
    SAG'in 40 rastgele robotunda iki filtreyi ayni IMU orneklerinde karsilastirir
    (0-19 ayar, 20-39 sinama). Sinamada RMS: tumleyen 0.98 0.87 deg, en iyi alpha 0.57,
    Kalman 0.27 deg. Kalman ile 20/20 kabul testi; SAG +-3 cm durma 37/40 -> 40/40.
    Ayrinti docs/KALMAN_FILTRE.md.
    [filtre_izgara.tsv, filtre_karsilastirma.tsv]
2026-11-09 LQG durum gozleyicisi (D2): denendi, varsayilan kapali; olumsuz sonuc belgelendi
    state_observer.h: [x, v, theta, omega, d] duragan Kalman gozleyicisi, L ve ayrik
    model lqr_design.py'den gains.h'a. CDTP_LQG=1/2 ile secilir, varsayilan 0.
    Acik dongu sinamada v RMS gozleyici 5.20 vs enkoder farki 4.58 mm/s; kapali
    dongude Kalman egimle 20/20 -> 13/20 (LQG=1). Neden ve sayilar docs/KALMAN_FILTRE.md.
    SAG robotlari sim/mc_robots.h'a tasindi (sim_main ve iki karsilastirma araci ortak).
    [gozleyici_izgara.tsv, gozleyici_karsilastirma.tsv]
2026-11-11 Gercek robot olculeri, TB6612 PCB v2, breadboard semasi, donanim testi
    - Olculen deger: govde 1,119 kg, KM 87,5 mm, teker 65 mm / 53 g, iz 270 mm; lqr_design, gains.h, plant_nominal.h, cdtp_config.h, twin guncellendi
    - Simulasyon: 20/20 kabul testi gecti (docs/OLCULER_VE_DENGE.md)
    - elektronik/pcb_v2: TB6612 ana karti (DRC 0 hata), Gerber zip, uretim notlari
    - docs/breadboard_*: tek breadboard semasi ve baglanti dogrulayici
    - firmware/bench: seri komutlu donanim testi (I2C, MPU6050, enkoder, IR, motor)
    - cad: pleksi DXF ve yerlesim, 37 mm motor braketi
    [cdtp_ana_kart_v2-B_Cu.gbl, cdtp_ana_kart_v2-B_Mask.gbs, cdtp_ana_kart_v2-B_Silkscreen.gbo, cdtp_ana_kart_v2-Edge_Cuts.gm1, cdtp_ana_kart_v2-F_Cu.gtl, cdtp_ana_kart_v2-F_Mask.gts, cdtp_ana_kart_v2-F_Silkscreen.gto, cdtp_ana_kart_v2-NPTH.drl]
2026-11-11 Breadboard semasi gercek kart duzenine gore: ESP32 21-3, MPU 23-30, TB6612 39-32, LM2596 41/57, ust 12 V alt 3,3 V
2026-11-12 Breadboard semasi 30 pinli ESP32 surumu ve 38'den 30'a gecis rehberi
2026-11-12 Robot-telefon baglantisi BLE'den Wi-Fi WebSocket'e (takim protokolu, shared/protocol/messages.md)
    Robot CDTP-ROBOT agini acar, ws://192.168.4.1:81/, 5 Hz telemetri, cmd ve ping/pong.
    ESP-NOW (eldiven) ayni kanalda calisir. Derleme ve birim testi gecti, donanimda denenmedi.
